1206likith/gesture-sentry/docs/guides/images/chassis-photo.png

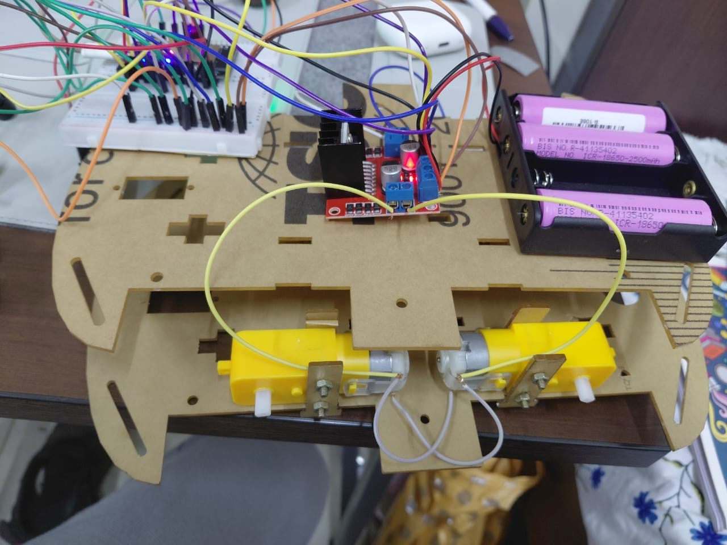
docs/guides/images/chassis-photo.png
