1206likith/gesture-sentry/docs/design/Advanced_Robotics_Project_Ideas.md

# 20 More Impressive Robotics + Embedded Systems Ideas — 4-Person Team

Upgrade tier from the sumo-bot/basic-demo list — these have more technical
depth, better demo "wow factor," and more genuinely interesting embedded
systems content (closed-loop control, sensor fusion, real-time
coordination), while still being scoped for 4 people in a few weeks (not
a research-lab timeline).

## Difficulty key
🟢 Same tier as sumo-bot (few weeks, moderate) · 🟡 Harder, needs one extra week / more careful tuning · 🔴 Genuinely ambitious, 5-6+ weeks, only if the team wants to push

---

**1. Self-Balancing Robot (Inverted Pendulum on Wheels)** 🟡
MPU6050 IMU + PID control loop keeps a 2-wheeled robot upright in real time — the classic "hard but learnable" control-systems project. Way more technically impressive than sumo because it's closed-loop control running continuously, not a discrete decision tree. Split: chassis/motor mounting (A), IMU+PID tuning (B — the hardest, most interesting part), motor driver firmware (C), app-based remote steering once balanced (D).

**2. Swarm of 3 Mini-Bots with Coordinated Behavior** 🔴
3-4 small bots communicate over ESP-NOW/BLE and perform coordinated formation-following or a simple "flocking" behavior (follow the leader, maintain spacing). Genuinely research-adjacent and a strong standout demo — each bot is simple individually, the coordination logic is the real content. Split naturally: each of 3 people builds/owns one bot, 4th person owns the coordination protocol + demo choreography.

**3. Autonomous Maze-Solving Robot (Flood-Fill / Wall-Following + Mapping)** 🟡
Beyond basic line-following: robot explores an unknown maze, builds an internal map, and on a second run takes the *optimal* solved path (flood-fill or A* on a grid). Genuinely impressive because it demonstrates it "learned" the maze. Split: chassis/motors+encoders (A), sensor array/wall-detection (B), pathfinding algorithm (C — the standout technical piece), UI showing the live map on a dashboard (D).

**4. Robotic Arm with Real Inverse Kinematics + Camera-Guided Pick-and-Place** 🔴
Upgrade of the earlier arm idea: instead of 3 hard-coded positions, use a phone/webcam + simple color-blob detection (OpenCV on a laptop, sending coordinates to the arm over WiFi) so the arm actually *locates* an object and computes the joint angles to reach it via inverse kinematics. This is the "genuinely impressive" version of the arm idea. Split: mechanical arm (A), servo/IK firmware (B — the hard math part), vision/color-detection pipeline (C), integration+calibration (D).

**5. Autonomous Line-Following Delivery Bot with Package Drop-Off Stations** 🟡
A line-following robot with RFID station-recognition — it detects which "station" it's at via an RFID tag embedded at each stop, and executes a scripted drop-off action (servo dumps a small payload) at the correct one, chosen via an app-selected destination before the run starts. More of a real "product demo" (mini delivery robot) than sumo's combat framing.

**6. Gesture-Controlled Robot (IMU-Wearable Glove → Robot Motion)** 🟢/🟡
A glove or wristband with an MPU6050 sends orientation data over BLE; tilting your hand forward/back/left/right drives the robot the same direction, in real time. Very demoable — a person visibly "steering with their hand" reads as much more impressive than a phone-app button, for similar build effort to the arm idea. Split: glove hardware+IMU (A), robot chassis/motors (B), gesture-classification firmware on the glove side (C), BLE link+robot-side motor mapping (D).

**7. Autonomous Fire-Fighting Robot (Flame Sensor + Water-Pump Extinguisher)** 🟡
Flame sensors (IR flame detector array) locate a small candle/flame source, robot navigates toward it and triggers a small water-pump/servo-spray mechanism to "extinguish" it — very popular competition-style project with strong safety-tech framing and a genuinely satisfying demo (robot finds and puts out a real flame). Split: chassis+pump/spray mechanism (A), flame-sensor array+localization (B), navigation firmware (C), integration/safety testing (D).

**8. Object-Sorting Conveyor with Color/Size Classification** 🟡
A small conveyor belt (DC motor + belt) moves objects past a color sensor (TCS3200) and/or an IR size-gate, and a servo-driven arm/flap diverts each object into the correct bin based on classification. Genuinely impressive "mini factory automation" demo, and technically rich (sensor calibration + timed actuation + classification logic). Split: conveyor mechanical build (A), color/size sensor calibration (B), sorting-logic firmware (C), bin mechanism + integration (D).

**9. Voice + Gesture Hybrid Smart Wheelchair/Mobility Model (small-scale demo)** 🔴
A scaled-down model (not full-size, for safety/cost) demonstrating assistive mobility tech: joystick + voice command + obstacle-avoidance override (ultrasonic emergency-stop regardless of command). Strong social-good framing, genuinely useful technical content (safety-override priority logic is a real embedded-systems lesson). Split similar to sumo's pattern but with a dedicated "safety override" firmware owner.

**10. Autonomous Drone-Style Ground Rover with GPS Waypoint Navigation** 🔴
Cheap GPS module + compass (HMC5883L) lets a rover navigate to GPS waypoints outdoors autonomously (drive to point A, then B, then C), rather than reacting only to nearby sensors. Genuinely more advanced than anything reactive-only (sumo, line-follower) because it requires real navigation math (bearing calculation, distance-to-waypoint). Needs outdoor testing space. Split: chassis/motors (A), GPS+compass integration (B — trickiest part, needs outdoor calibration), waypoint-navigation firmware (C), live-tracking dashboard (D).

**11. Robotic Arm + Sumo-Bot Hybrid: "Combat Arm" that Grabs and Ejects Objects from a Ring** 🟡
A genuinely fun combination: a stationary or slow-moving base with a robotic-arm-style gripper that must locate small objects (via ultrasonic/IR) within a ring and physically pick-and-eject them, rather than push. Combines the sensor-based ring-awareness logic of the sumo idea with real gripper mechanics — technically richer than either idea alone, still buildable in similar time.

**12. Self-Parking Robot Car (Ultrasonic Mapping + Reverse-Parking Maneuver)** 🟡
Robot uses ultrasonic sensors to detect a "parking gap" between two obstacles and autonomously executes a multi-step reverse-parking maneuver (a scripted but sensor-triggered sequence, like real self-parking cars) — genuinely satisfying to watch and technically non-trivial (must correctly judge gap size before committing to the maneuver).

**13. Robotic Sentry Turret (Pan-Tilt + Ultrasonic/PIR Target Tracking, Non-Lethal "Tag")** 🟢/🟡
A stationary pan-tilt mount (2 servos) with an ultrasonic or PIR sensor tracks and aims at a moving target (a person walking past), optionally firing a foam dart or laser-pointer "tag" when locked on. Very demoable, needs no chassis/motors at all — purely a tracking/aiming project, which is a nice change of pace and a faster build (fewer moving mechanical parts than a driving robot).

**14. Two-Robot "Capture the Flag" with Wireless Coordination** 🔴
Two autonomous robots on a small field, each trying to reach a "flag" zone first, using ultrasonic obstacle-avoidance and a simple WiFi/ESP-NOW channel to broadcast their own position so each robot can react to (or ignore) the other. Much more interesting than 1-robot sumo because of the added multi-agent-awareness dimension.

**15. Robotic Arm Assembly-Line Simulator (Multi-Station Handoff)** 🔴
Two small robotic arms pass an object between them in sequence (arm 1 picks from station A, hands to arm 2, arm 2 places at station B) — demonstrates real coordination/timing between two independent embedded systems, a genuinely more advanced "industrial automation" story than a single arm.

**16. Autonomous Wall-Climbing/Stair-Climbing Mini-Robot** 🔴
A tracked (not wheeled) chassis with a simple stair-climbing mechanism (offset tracks or a rocker-bogie-style suspension) — very high mechanical-build difficulty but an extremely strong demo if the team has some mechanical aptitude and wants the most "impressive-looking" hardware in this whole list.

**17. Smart Robotic Guide Dog / Obstacle-Guiding Cane (Assistive Tech)** 🟡
A handheld or robot-mounted device using ultrasonic sensors that vibrates/beeps with increasing intensity as an obstacle gets closer, simulating assistive navigation tech for visually impaired users. Strong social-good angle, technically simpler than a driving robot (no motors needed at all if built as a handheld cane), good if the team wants high impact for lower mechanical-build risk.

**18. Autonomous Robot Football/Soccer Player (Ball-Tracking + Goal-Scoring)** 🔴
Color-based ball detection (a bright orange/pink ball + simple color sensor or basic camera+laptop vision) drives the robot to chase and push the ball toward a goal. Genuinely popular competition category (RoboCup-style, scaled down), strong demo appeal, moderate-high difficulty from the vision/tracking side.

**19. Modular Snap-Together Robot Kit (Reconfigurable Chassis Demo)** 🟡
Instead of one fixed robot, build a chassis with quick-swap modules (swap a wheel-drive base for a tracked base, swap a gripper module for a sensor-only module) and demo 2-3 different "configurations" of the same core electronics. More of an engineering-design showcase than a single-behavior demo — good if the team wants to show design versatility rather than one flashy trick.

**20. Autonomous Warehouse "AGV" (Automated Guided Vehicle) with Barcode/QR Waypoints** 🟡
A line-following or grid-navigating robot that reads QR codes at each junction (via a cheap camera module or even a phone mounted on the robot running a QR-scanning app that sends the result over WiFi) to decide which path to take next, simulating a real warehouse AGV. Strong "real industry" framing (this is literally how Amazon warehouse robots work at a basic level).

---

## Comparison table (vs. the sumo-bot baseline)

| # | Idea | Difficulty | Extra weeks vs. sumo | Wow-factor | Best if team wants... |
|---|---|---|---|---|---|
| 1 | Self-balancing robot | 🟡 | +1 | Very high | Real control-systems learning (PID) |
| 2 | 3-bot swarm coordination | 🔴 | +2-3 | Highest | Most "research-y," most impressive to judges |
| 3 | Maze-solving + mapping | 🟡 | +1 | High | Algorithm-heavy, less mechanical risk |
| 4 | Vision-guided robotic arm | 🔴 | +2 | Very high | Computer vision + real IK math |
| 5 | Line-follow delivery bot | 🟡 | +0-1 | Medium-high | "Real product" framing, moderate risk |
| 6 | Gesture-controlled robot | 🟢/🟡 | +0-1 | High | Best effort-to-wow ratio on this list |
| 7 | Fire-fighting robot | 🟡 | +1 | High | Popular competition format, satisfying demo |
| 8 | Sorting conveyor | 🟡 | +1 | High | "Mini factory," different from driving robots |
| 9 | Assistive mobility model | 🔴 | +2 | High + social impact | Strongest social-good story |
| 10 | GPS waypoint rover | 🔴 | +2 | High | Real navigation math, needs outdoor space |
| 11 | Combat arm hybrid | 🟡 | +1 | High | Combines sumo + arm ideas cleverly |
| 12 | Self-parking robot | 🟡 | +1 | High | Very relatable "real car tech" demo |
| 13 | Sentry turret tracker | 🟢/🟡 | +0 | High | Fastest build, no chassis/motors needed |
| 14 | 2-robot capture-the-flag | 🔴 | +2 | Very high | Multi-agent systems, most "alive" demo |
| 15 | Dual-arm handoff | 🔴 | +2-3 | Very high | Industrial-automation storytelling |
| 16 | Stair-climbing robot | 🔴 | +2-3 | Highest visual | Team has mechanical/CAD strength |
| 17 | Assistive guide-cane | 🟡 | +0 | Medium-high | Lowest mechanical risk, high social impact |
| 18 | Robot soccer player | 🔴 | +2 | Very high | Vision+sports framing, popular format |
| 19 | Modular snap-together kit | 🟡 | +1 | Medium-high | Engineering-design showcase over one trick |
| 20 | QR-code AGV | 🟡 | +1 | High | "Real Amazon warehouse" framing |

## My honest recommendation

If the goal is genuinely "better and more impressive than sumo, but still finishable" — **#1 (self-balancing robot)**, **#6 (gesture-controlled robot)**, or **#13 (sentry turret)** are the sweet spot: each is a clear step up in technical sophistication and demo appeal, without jumping into the 5-6-week 🔴 tier.

If the team wants to genuinely swing for "best in the room" and has some slack in the timeline: **#2 (swarm coordination)** or **#14 (two-robot capture-the-flag)** are the most impressive on this entire list — multi-agent systems reliably stand out because almost no student teams attempt them, but budget real extra time and expect more integration pain across 3-4 separate robots instead of one.
