1206likith/gesture-sentry/docs/design/comparison_dashboard.html

ESA_Friend_Project · decision reference

# Every project option, side by side

Four idea sets were generated across this thread for slightly different goals. This page puts all 62 ideas in one sortable table, plus the two options that have a full build spec written. Use the filters to narrow by source or by budget/timeline.

SET 1 · 21 ideas

### Course-paper style

BACSE324-scoped, needs a paper/patent angle. Mostly 1–3 person scope. Project_Ideas_Brainstorm.md

SET 2 · 20 ideas

### Simple hardware demo

No paper needed. 50/50 hw/sw, built for a clean 4-way split, few weeks. Hardware_Demo_Project_Ideas.md

SET 3 · 20 ideas

### Advanced robotics

More technical depth & demo wow-factor than Set 2's baseline. Advanced_Robotics_Project_Ideas.md

2 full specs

### Built out in full

BOM, 4-way split, control logic, week-by-week timeline already written.

## Fully-specced options

Only these two have a complete build document — BOM with costs, exact 4-person role split, control logic, and a week-by-week timeline.

Superseded

### Voice-Controlled Robotic Arm

Set 2, idea #15 — basic pick-and-place

Cost

~₹4,000–4,500

Timeline

3 weeks + 1 buffer

Split

Mechanical build / servo firmware / app+voice / integration

Note

Replaced by the sumo robot as the working choice; kept here as reference. A vision-guided upgrade of this idea exists in Set 3 (#4).

Current pick

### Autonomous Sumo-Fighting Robot

Replaces the arm — chosen working project

Cost

~₹3,500–4,000

Timeline

3–4 weeks realistic, up to 5–6 if tuning drags

Split

Chassis/drivetrain / sensor mounting / control firmware / integration+tuning

Difficulty

Moderate overall — mechanical grip/weight and IR-edge calibration are the real time sinks, not the code

## All 62 ideas

Filter by source set, then scan cost and difficulty. "Best for" is copied from each idea's own writeup — it's the one-line reason to pick it.

Source All (62) Course-paper (21) Simple hw-demo (20) Advanced robotics (20)

Set | Idea | Domain / what it demos | Cost or Δ vs. baseline | Difficulty | Best for
Set 1 | SPI eavesdrop / injection | Robotics / drone sensors | ~₹0 | Moderate | Sensor-fusion story
Set 1 | UART command injection | Industrial actuators | ~₹0 | Low–mod | Fast, simple build
Set 1 | Modbus RTU injection | Industrial / PLC | ~₹200 | Moderate | Strong "PLC" framing
Set 1 | I2C address-spoofing | Consumer multi-sensor | ~₹0 | Moderate | Differentiates from existing I2C project
Set 1 | SPI flash glitching | Hardware / secure boot | ~₹150 | High | Wow-factor, riskier
Set 1 | Priority inversion | Pure RTOS | ₹0 | Low | Cheapest + fastest, textbook-safe
Set 1 | GPIO interrupt storm | Generic embedded | ~₹0 | Low | Easiest live demo
Set 1 | Timer / tick manipulation | Safety-critical timing | ~₹0 | Moderate | Nuanced RTOS-internals angle
Set 1 | Watchdog bypass / abuse | Safety systems | ₹0 | Moderate | Under-explored, examiner-friendly
Set 1 | Stack-overflow corruption | Firmware reliability | ₹0 | Moderate | Strong "found a real bug" narrative
Set 1 | ADC glitching via rail noise | Automotive / industrial sensors | ~₹150 | Moderate | Hands-on hardware feel
Set 1 | Sleep/wake timing attack | Battery IoT / wearables | ~₹100 | Moderate | Attacks energy budget, not CPU time
Set 1 | Brown-out induced reset | Safety-critical ECUs | ~₹100 | Moderate | Real automotive failure class
Set 1 | NTP poisoning | Distributed sensor nets | ₹0 | Moderate | Multi-node distributed-systems story
Set 1 | MQTT broker flooding | Cloud IoT | ₹0 | Low–mod | Real-product framing, portfolio value
Set 1 | DNS spoofing | IoT / OTA security | ₹0 | Moderate | Timely, maps to real CVEs
Set 1 | Multi-core task migration jitter | General computing | ₹0 | Low | Fastest / cheapest overall
Set 1 | Cache / flash WCET variance | RT systems theory | ₹0 | Low–mod | Safest, most "textbook"
Set 1 | GPS/GNSS spoofing | Automotive / drone nav | ~₹500 | High | Highest wow-factor, check parts first
Set 1 | Bluetooth Classic SPP flood | Legacy industrial serial | ₹0 | Low | Weakest pick, well-trodden
Set 1 | CAN-FD bit-rate-switch | Next-gen automotive | ~₹300+ | High | Most novel, riskiest on hardware sourcing
Set 2 | Smart parking indicator | Ultrasonic/IR ×4–6, LED matrix | 2–3 wks | Low | Fast, cheap, very demoable
Set 2 | Gas leak + auto-vent | MQ gas sensor, relay, fan, buzzer | 2–3 wks | Low | Strong safety story
Set 2 | Smart irrigation | Soil sensors, relay, pump | 2–3 wks | Low | Classic, cheap, reliable parts
Set 2 | RFID attendance / lock | RFID reader, servo lock | 2–3 wks | Moderate | Clean 4-way split
Set 2 | Home automation (app + voice) | Relay bank | 2 wks | Low | Fastest software-heavy option
Set 2 | Line-follow / obstacle robot | Chassis, motors, IR/ultrasonic | 3–4 wks | Moderate | Best "robot" wow-factor at this tier
Set 2 | Smart dustbin | Servo lid, ultrasonic ×1–2 | 2 wks | Low | Very simple, cheap
Set 2 | Weather station | Temp/humidity/pressure/rain/light | 2–3 wks | Low | Software / dashboard-heavy
Set 2 | Energy meter | Current / voltage sensor | 3 wks | Moderate | Practical, needs electrical care
Set 2 | Dual-factor door lock | Fingerprint + RFID + servo | 3–4 wks | Moderate | Most "security system" feel
Set 2 | Watering + grow-light | Moisture + LDR + 2 relays | 3 wks | Moderate | More subsystems to split
Set 2 | Mini smart traffic light | LEDs ×4, ultrasonic ×4 | 3 wks | Moderate | Best visual demo at this tier
Set 2 | Fall-detection wearable | MPU6050 wearable | 2–3 wks | Low–mod | Medical-IoT framing
Set 2 | Adaptive street-light model | LDR + PIR, LEDs | 2 wks | Low | Simplest firmware, more mounting work
Set 2 | Voice / app robotic arm (superseded) | 3–4 servo arm | 3–4 wks | Moderate | Good hardware build challenge — full spec exists, now replaced by sumo
Set 2 | Smart scarecrow | PIR/ultrasonic, buzzer, servo | 2 wks | Low | Fun, easy indoor demo
Set 2 | Health vitals monitor | Pulse + temp sensor wearable | 2–3 wks | Low–mod | Clean 3-way split
Set 2 | Smart bike safety system | Buttons, LEDs, accelerometer, ultrasonic | 3 wks | Moderate | Good mechanical-mounting work
Set 2 | Automated pet feeder | Servo/auger dispenser, load cell/IR | 3 wks | Moderate | Popular, well-documented
Set 2 | Smart mailbox notifier | Reed switch/IR, optional weight sensor | 1–2 wks | Low | Fastest / simplest overall
Set 3 | Self-balancing robot | MPU6050 + PID, inverted pendulum | +1 wk | Moderate | Real control-systems learning (PID)
Set 3 | 3-bot swarm coordination | ESP-NOW/BLE formation-following | +2–3 wks | High | Most "research-y," most impressive to judges
Set 3 | Maze-solving + mapping | Flood-fill / wall-following + live map | +1 wk | Moderate | Algorithm-heavy, less mechanical risk
Set 3 | Vision-guided robotic arm | Color-blob detection + inverse kinematics | +2 wks | High | Computer vision + real IK math
Set 3 | Line-follow delivery bot | RFID station stops + payload drop | +0–1 wk | Moderate | "Real product" framing, moderate risk
Set 3 | Gesture-controlled robot | IMU glove over BLE → motion | +0–1 wk | Low–mod | Best effort-to-wow ratio on this list
Set 3 | Fire-fighting robot | Flame sensor array + pump/spray | +1 wk | Moderate | Popular competition format, satisfying demo
Set 3 | Sorting conveyor | Color/size sensor + diverter servo | +1 wk | Moderate | "Mini factory," different from driving robots
Set 3 | Assistive mobility model | Joystick + voice + safety-override | +2 wks | High | Strongest social-good story
Set 3 | GPS waypoint rover | GPS + compass, real navigation math | +2 wks | High | Real nav math, needs outdoor space
Set 3 | Combat arm hybrid | Sumo ring-awareness + gripper eject | +1 wk | Moderate | Combines sumo + arm ideas cleverly
Set 3 | Self-parking robot | Ultrasonic gap-mapping + reverse maneuver | +1 wk | Moderate | Very relatable "real car tech" demo
Set 3 | Sentry turret tracker | Pan-tilt + ultrasonic/PIR tracking | +0 wk | Low–mod | Fastest build, no chassis/motors needed
Set 3 | 2-robot capture-the-flag | Wireless position broadcast + strategy | +2 wks | High | Multi-agent systems, most "alive" demo
Set 3 | Dual-arm handoff | Two arms pass an object in sequence | +2–3 wks | High | Industrial-automation storytelling
Set 3 | Stair-climbing robot | Tracked chassis, offset/rocker suspension | +2–3 wks | High | Team has mechanical/CAD strength
Set 3 | Assistive guide-cane | Ultrasonic + vibration feedback | +0 wk | Moderate | Lowest mechanical risk, high social impact
Set 3 | Robot soccer player | Color-based ball tracking + goal-scoring | +2 wks | High | Vision + sports framing, popular format
Set 3 | Modular snap-together kit | Quick-swap chassis modules | +1 wk | Moderate | Engineering-design showcase over one trick
Set 3 | QR-code AGV | Grid nav + QR junction reads | +1 wk | Moderate | "Real Amazon warehouse" framing

## Where this leaves you

If your friend wants "better than sumo" but still low-risk: Self-balancing robot, gesture-controlled robot, or sentry turret tracker (Set 3, #1/#6/#13) — each is a genuine step up in technical depth and demo appeal without leaving the "few weeks, moderate difficulty" zone the sumo bot occupies.

If the team wants to swing for the most impressive thing on this entire page: 3-bot swarm coordination or 2-robot capture-the-flag (Set 3, #2/#14) — genuinely stand out because almost no student team attempts multi-agent coordination, but budget real extra weeks and expect more integration pain across multiple robots.

If the goal shifts back to course marks (paper/patent) instead of a standalone demo: Set 1's priority-inversion or GPIO-interrupt-storm ideas need zero extra hardware and map directly onto Module 4 (RTOS) of the syllabus.

62 ideas across 4 documents · docs/Project_Ideas_Brainstorm.md · Hardware_Demo_Project_Ideas.md · Advanced_Robotics_Project_Ideas.md · Robotic_Arm_Full_Spec.md · Sumo_Robot_Full_Spec.md
