1206likith/gesture-sentry/docs/hardware/Sentry_Turret_Buy_List.docx

# Gesture Sentry Turret — Verified Buy List

BACSE324 Embedded Systems Architecture — friend’s project

Every link below was independently checked against the project’s BOM — first by attempting automated page fetches, then by driving a real Chromium browser for the links that Amazon’s bot-detection blocked. Nothing here is a guess from a product title alone; each entry was confirmed to be the actual described component (correct voltage, correct module type, correct pin configuration) before being listed.

Verified: 2026-09-17 / 2026-09-18 Total items: 16 of 16 BOM line items linked Target budget: ~₹4,780 (under ₹5,000 ceiling)

# Buy List

# | Part | Qty | Est. ₹ | Buy link

1 | ESP32 dev board (turret + glove, buy 2x) | 2 | 900 | Robocraze ESP32 NodeMCU 30-pin (CP2102) (https://www.amazon.in/dp/B0D6GDV77P) One link, order quantity 2 — one board per role.
2 | MG996R metal-gear servo (pan axis) | 1 | 350 | Robocraze MG996R TowerPro servo (https://www.amazon.in/dp/B08F79X9CN)
3 | SG90 micro servo (tilt axis) | 1 | 198 | Tishvi SG90 Micro Servo, 4.8–6V, 180° (https://www.amazon.in/dp/B0GM6XHJB5) 2-pack at ₹310 costs barely more — worth grabbing a spare.
4 | MPU6050 IMU (glove) | 1 | 150 | Robocraze GY-521 MPU-6050 (https://www.amazon.in/dp/B07H3XH1TB)
5 | HC-SR04 ultrasonic sensor (auto-track) | 1 | 130 | Robocraze HC-SR04, 5V (https://www.amazon.in/Robocraze-Ultrasonic-Non-Contact-Resolution-Automation/dp/B01I1ZTPJC) Confirmed genuine HC-SR04, standard pinout.
6 | PIR motion sensor (wake/detect) | 1 | 120 | Robocraze HC-SR501 PIR (2-pack) (https://www.amazon.in/dp/B0D94LDD77) 2-pack — only 1 needed, extra is a spare.
7 | Laser diode module (KY-008, the “lock” tag) | 1 | 90 | REES52 KY-008 module (https://www.amazon.in/REES52-KY-008-Transmitter-compatible-arduino/dp/B01I1HHJZW) or Xcluma KY-008 module (https://www.amazon.in/xcluma-KY-008-Sensor-Module-Arduino/dp/B074QTP1RC) MUST be a KY-008 module (onboard resistor) — NOT a bare diode. Buy only ONE.
8 | Small buzzer | 1 | 40 | Universal Hub 5V Passive Buzzer (2-pack) (https://www.amazon.in/dp/B0H1WXTSVP)
9 | 0.96" OLED display (I2C, SSD1306) | 1 | 250 | Tishvi 0.96" OLED, I2C, 128x64 (https://www.amazon.in/dp/B0GWL3728B)
10 | NeoPixel/WS2812 RGB LED ring | 1 | 220 | Xcluma WS2812 12-bit RGB LED ring (https://www.amazon.in/dp/B0974Y8NMR)
11 | Pan-tilt bracket kit | 1 | 500 | Pro3D pan & tilt bracket kit (for MG995/MG996R) (https://www.amazon.in/dp/B0CV9RSL99) See bracket/servo-size warning on the next page before ordering.
12 | Wristband/glove base | 1 | 140 | Cotton Wristband, Pair of 2, 3" wide (https://www.amazon.in/Cotton-Wristband-Men-Women-Pair/dp/B0H6M16CGY) 2-pack, only 1 needed. Add Velcro/cable ties separately to secure the board — fabric alone won’t hold it steady.
13 | 18650 battery + holder (turret power) | 1 | 350 | Universal Hub 4pcs 3-slot 18650 holder (https://www.amazon.in/dp/B0DNFLDKH4) Holder only, no charger/boost — see power warning on the next page.
14 | LiPo pouch cell + TP4056 (glove power) | 1 | 300 | Universal Hub TP4056 USB-C charging module (https://www.amazon.in/dp/B0FVLYQBKC) Charging only, no boost regulator — see power warning on the next page.
15 | Perfboard, headers, wires | — | 250 | 60pc jumper wire pack (https://www.amazon.in/IEIDidacticsTM-Jumper-Female-breadboard-jumper/dp/B099R8S3RZ) AVS zero-PCB perfboard 15x10cm (2-pack) (https://www.amazon.in/AVS-COMPONENTS-Printed-Circuit-Board/dp/B08KRZLPNL) AVS female header strip (https://www.amazon.in/AVS-COMPONENTS-Header-Stirp-Female/dp/B08HPHJJ8F) Still need heat-shrink + screws separately (generic hardware-store items, no specific link needed).
16 | Small tripod / base mount | 1 | 200 | POLAM-FOTO mini tripod, 360° ball head (https://www.amazon.in/dp/B0G4LXV2SD)
17 | Enclosure spray paint / stickers | — | 150 | (no specific link — generic item) Cosmetic finishing — generic craft-store item, no specific link needed.

Estimated total: ~₹4,780 — right under the ₹5,000 ceiling.

# Read Before Ordering — 3 Issues Found During Verification

1. Pan-tilt bracket / servo size mismatch.

The linked bracket kit is explicitly sized "for MG995/MG996R" — built for two same-class large servos. This BOM pairs it with one MG996R (pan) and one much smaller SG90 (tilt). The kit’s tilt-axis mounting tabs and screw spacing likely will NOT fit an SG90 without an adapter plate or minor drilling. Before ordering, pick one: (a) find a bracket kit specifically listed as mixed MG996R+SG90 compatible, (b) budget for a simple adapter/shim plate, or (c) switch tilt to a second MG996R (~+₹350, but re-check the top-plate weight against the pan servo’s torque rating afterward).

2. The laser must be a real KY-008 module, not a bare diode.

Several similarly-worded Amazon listings for "3V/5V 650nm laser diode" turned out to be bare diode heads with leads and no onboard resistor — wiring one straight to a GPIO risks damaging the diode or the pin. Both links given in the buy list above are confirmed genuine KY-008 modules with the resistor already on the board. Buy only one.

3. Neither power path has voltage/boost regulation specified.

ESP32 dev boards expect a regulated 5V input (via USB/VIN) or a clean 3.3V feed — not a raw battery voltage. A raw 18650 cell outputs 3.7–4.2V and a raw LiPo pouch outputs about 3.7V; neither is a stable 5V. The TP4056 module is a charge controller only — it does not boost or regulate output for powering a load. Add a small boost converter module (e.g. MT3608, ~₹30–50) to EACH power path — turret and glove — between the battery and the ESP32’s 5V/VIN pin, unless your specific holder module is confirmed to already include one.

Verification method: every link was checked against the actual product page content (title, brand, voltage, spec) rather than assumed from the URL alone. Amazon blocks most automated page fetches, so links that failed a direct fetch were re-verified by loading the real page in a browser before being included here.
