1206likith/gesture-sentry/docs/hardware/glove_mounting_diagram.png

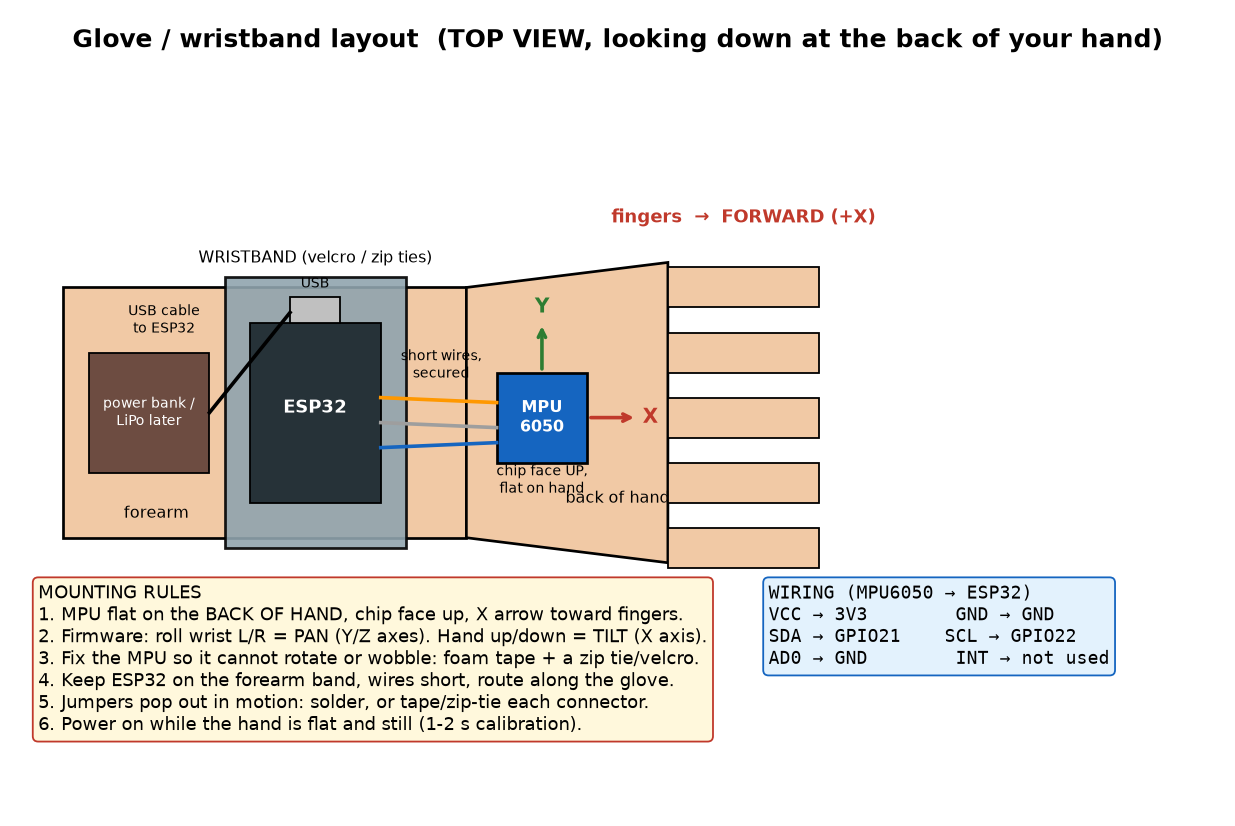
docs/hardware/glove_mounting_diagram.png
