1206likith/gesture-sentry/docs/hardware/pan_tilt_DIY_diagram.png

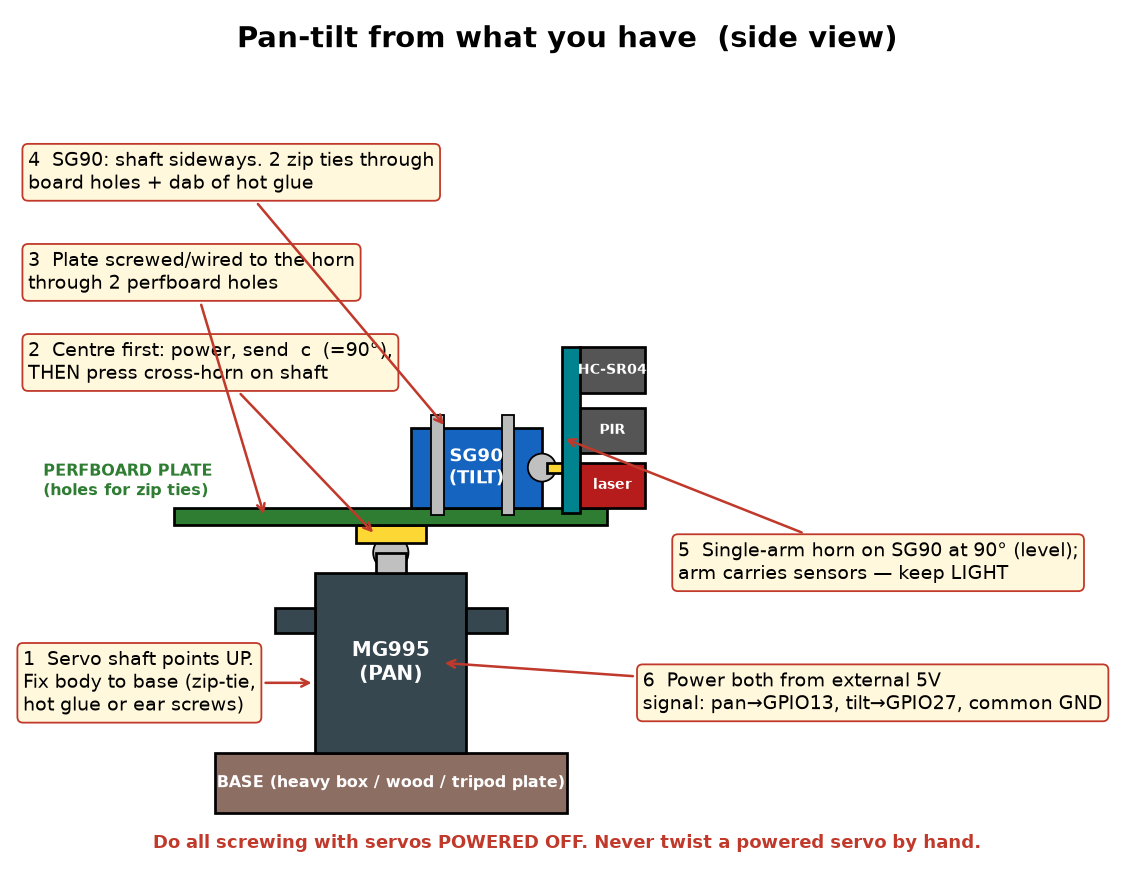
docs/hardware/pan_tilt_DIY_diagram.png
