1206likith/gesture-sentry/docs/guides/PROGRESS_2026-10-27.md

# Gesture Sentry — progress and results, 2026-10-26/27

Everything below was observed this session unless marked "not verified". Serial output proves the boards commanded something; only the user's eyes prove a wheel turned or an LED lit.

## Hardware verified
| Item | Result |
|---|---|
| Glove MPU (MPU6500, WHO_AM_I 0x70, addr 0x68) | live data; SDA/SCL wiring correct; chip mounted upside-down against the hand (handled by the learned orientation) |
| Glove -> turret Bluetooth link | link=1, glove angles reach the turret live, gestures arrive and are acted on |
| OLED (0x3C) | answers after reseating; text drawn (user saw text); not re-checked after the last firmware |
| Servo outputs | pan GPIO13 / tilt GPIO27 attached at 50 Hz; physical sweep not confirmed by the user |
| L298N wheels | all four wheel/direction pulses at duty 180 worked ("all worked"); stayed still with no command |
| Ultrasonic | returns echoes; readings erratic (needs a fixed-target test) |
| PIR, laser | NOT tested (laser needs a confirmed safe beam path) |

## Faults found and what they were
- "Car runs full speed on battery": not firmware (wheels start disabled, drive needs a command). Cause class: L298N ENA/ENB jumper caps and/or ESP32 powered badly on battery. Resolved when ENA/ENB were wired to GPIO2/GPIO15 with the caps removed: wheels stay still until commanded.
- Wheels did not turn from the glove: glove-requested duty was ~61-64/255, below what the motors need to start. Fixed in firmware: duty now starts at MIN_PWM=90 past the dead zone and ramps to MAX_PWM=200 (was 0..120). Flashed to the turret; the forward test with the new duty was NOT completed (paused).
- "Diagonal wheels in opposite directions" (earlier): each motor pair needs one motor's wires swapped. User later reported all wheels working on pulses; per-motor forward direction under glove drive NOT re-confirmed.
- Flashing the turret fails with "wrong boot mode 0xb" when ENA is on GPIO2 and the L298N pulls it up. It did flash with ENA wired in the later runs, but unplug ENA if it fails.
- USB serial ports change (COM5/COM8/COM14) when cables or boards are swapped; identify a board by its output (`link=` = turret, `GLOVE` = glove), not by COM number. At pause, both ports showed W1 boards, so neither board was on the PC.
- Disk: C: is 100% full. Host-compiler caches were put on L:.

## Glove orientation (learned, stored in the glove's flash)
Serial commands on the glove (115200): `f` capture flat, `d` capture fingers-down (do `f` then tip and send `d`), `o` one-shot version, `c` recalibrate neutral (hold flat), `r` reset. Saved frame (second calibration): fwd=(-0.98,0.09,-0.18) left=(0.08,1.00,0.04) up=(0.18,0.02,-0.98). After `d` always do `c` with the hand flat: the automatic recalibration runs while still tipped. A glove that reboots calibrates neutral in whatever pose it is in (this caused a bogus -96 degree roll once).
Verified: roll right -> pan above 90; fingers down -> tilt below 90.

## Gestures (see GESTURES.md)
Real glove results: double flick, shake (switches drive/turret) and punch were detected on the real glove and the turret acted on them. Sweeps were not (see below). STILL no longer stops the car (it conflicted with the half-second level hold used to arm the wheels); it is only reported.
Measured on this user: a jab gives a 5-8 m/s2 forward spike (slow filter), rotation under ~4.7 rad/s; the user's "sweep" is an edge-on swat with 10-14 rad/s rotation about the real vertical and a forward push.
Synthetic tests (tests/test_gestures.cpp, host compiler via Zig): all gestures >90%, 0 false actions in a simulated hour. They check logic only, not real-wrist accuracy.

## State of the source vs what is flashed
- Turret: flashed = latest source (STILL no-op, MIN_PWM 90 / MAX_PWM 200, parses `seq,pan,tilt[,evSeq,evCode]`).
- Glove: flashed = an EARLIER build (faster punch filter, yaw about the vertical, debug "GLOVE peak" lines; but before the sweep/punch-window fix). The source in glove/Gestures.h is newer and NOT flashed.
- OPEN BUG in the newer source: 1 deterministic synthetic case fails ("sweep (yaw +) -> SWEEP_LEFT") and sweep trials are 94.7%, down from 100% after the sweep/punch-window change. Investigate before flashing.

## Next steps
1. Fix the failing sweep case, rerun tests, flash the glove, re-test punches/sweeps/shake on the real hand.
2. Finish the drive test with the new duty (wheels lifted first): forward, reverse, steer, then confirm all four wheels turn the same way; then floor test.
3. Power the ESP32 properly from battery (buck to 5V, or L298N 5V pin only if the pack is ~7-8V); measure the pack first. Never drive from a 4S (16.8V) pack unregulated.
4. Mount the pan/tilt servos (docs/hardware/pan_tilt_DIY_diagram.png) and the glove (docs/hardware/glove_mounting_diagram.png); test PIR, ultrasonic at a fixed target, and (only with a safe beam path) the laser.
5. Decide whether the course needs a TinyML component; the current detector is rule-based.
