1206likith/gesture-sentry/docs/hardware/Sentry_Turret_Build_Manual.docx

GESTURE-CONTROLLED SENTRY TURRET

End-to-End Build Manual & Project Plan

On-device TinyML gesture recognition · pan-tilt auto-tracking · 4-person build, 4 weeks, ₹4,780 budget

Team size | 4 people
Timeline | 4 weeks
Budget | ₹4,780 (ceiling ₹5,000)
Core tech | ESP32 × 2, MPU6050, TFLite Micro (Edge Impulse)
Gesture set | 5 core + 3 stretch (8 total)

# Contents

# 1. Project Overview

A pan-tilt sentry turret that auto-tracks a moving target using an ultrasonic sensor and a PIR motion sensor, and can be switched into manual mode and driven by real hand gestures. Gesture recognition runs entirely on-device: a small trained model (TensorFlow Lite Micro, built via Edge Impulse) classifies IMU motion patterns on the glove's own ESP32 and sends a recognized command over Bluetooth Low Energy — no laptop or phone is needed at demo time.

This build replaces two earlier candidates considered for this slot: a voice-controlled robotic arm (mechanically heavier, servo-IK dependent) and an autonomous sumo-fighting robot (a solid baseline, but this turret gives more technical depth for similar cost and less mechanical risk, since it needs no chassis, drivetrain, or wheels).

## 1.1 Why this project

- No drivetrain to fight — the single biggest source of unreliability in student robotics builds (traction, motor stall, uneven floors) simply doesn't exist here.
- Genuine embedded-AI content — an on-device trained model is a real technical differentiator, not just sensor-threshold logic.
- Clean 4-way split with almost no idle time — three people can work fully in parallel for two weeks before any integration is needed.
- Strong, fast demo — auto-track alone is a complete fallback demo; the gesture layer is additive polish, not a single point of failure.

Read this first — the honest risk call

Training 8 gestures to run reliably on-device in 4 weeks, with a team likely new to ML, is ambitious.

This plan includes a fallback checkpoint at the end of Week 2: if the core 5 gestures aren't hitting roughly 85%+ accuracy on someone new by then, the team deliberately drops the 3 stretch gestures rather than risking a broken demo.

This is not a failure mode — it is the plan.

# 2. Bill of Materials

Total: approximately ₹4,780, against a ₹5,000 ceiling. No extra hardware is required for the AI upgrade — the trained model runs entirely on the ESP32 already listed below; the real cost of "AI" here is time (data collection and training), not parts.

Part | Qty | ₹ | Notes
ESP32 dev board (turret) | 1 | 450 | Servo control + BLE receive + action mapping
ESP32 dev board (glove) | 1 | 450 | Runs the on-device TFLite Micro model
MG996R metal-gear servo (pan) | 1 | 350 | Carries the full sensor rig — needs the torque
SG90 micro servo (tilt) | 1 | 130 | Lighter axis, SG90 is sufficient
MPU6050 IMU (glove) | 1 | 150 | Accelerometer + gyro — the model's input signal
HC-SR04 ultrasonic (auto-track) | 1 | 130 | Front-facing distance/presence sensing
PIR motion sensor (wake/detect) | 1 | 120 | Wakes auto-tracking on motion
Laser diode module (3V, KY-008) | 1 | 90 | Class 1/2 visible dot only — see Section 7 safety note
Small buzzer | 1 | 40 | Audible confirmation on gesture + lock
0.96" OLED display (I2C, SSD1306) | 1 | 250 | Live mode / gesture label / confidence / status
WS2812 RGB LED ring (8–12 LED) | 1 | 220 | Status ring: green / amber / red
Pan-tilt bracket kit (generic) | 1 | 500 | Buy a kit — do not fabricate from scratch
Wristband/glove base | 1 | 100 | Mounts the glove ESP32 + MPU6050
18650 battery + holder + charger (turret) | 1 | 350 | Untethered turret
LiPo 3.7V pouch cell + TP4056 (glove) | 1 | 300 | Untethered glove — essential for the illusion to work
Perfboard, headers, wires, heat-shrink, screws | – | 250
Small tripod / base mount | 1 | 200 | Height matters for demo visibility
Cosmetic finishing (paint, labels) | – | 150 | Disproportionate wow-per-rupee

# 3. The AI Toolchain

Use free, well-documented tools only — do not attempt to build the ML pipeline from scratch in the Arduino IDE.

## 3.1 Edge Impulse (free tier, web-based)

The standard path for “collect IMU data → train a model → export TFLite Micro → run on ESP32.” It has an official ESP32 tutorial and handles data collection, labeling, training, and C++ export in one flow.

## 3.2 Model type

Use Edge Impulse's default “Motion Classification” project template — a small 1D-CNN or fully-connected network over a fixed-length window of accelerometer+gyro samples (roughly 1–2 second windows at 50–100Hz). Do not design a custom architecture.

## 3.3 Data collection — the real bottleneck

Each gesture needs approximately 40–60 recorded samples per team member (150–250 samples per gesture in total) to generalize beyond one person's exact motion style. This is the single biggest time cost in the whole project — budget real hours across Week 1–2, not an afternoon.

Most common TinyML mistake

A model trained on one person's motion style may not generalize to anyone else.

Always validate accuracy with someone who did NOT contribute training data before trusting the number.

# 4. The Gesture Set

8 gestures total: a core 5 that alone form a complete, demoable system, and 3 stretch gestures attempted only once the core 5 are solid.

# | Gesture | Command | Tier

1 | Tilt left / hold | Pan left (continuous while held) | Core
2 | Tilt right / hold | Pan right (continuous while held) | Core
3 | Sharp forward flick | LOCK — laser + buzzer + red ring | Core
4 | Wave (side-to-side shake) | Reset to idle / auto-track | Core
5 | Quick double-tap motion | Switch AUTO ↔ MANUAL | Core
6 | Tilt up / hold | Tilt servo up (continuous) | Stretch
7 | Tilt down / hold | Tilt servo down (continuous) | Stretch
8 | Circular wrist rotation | “Scan” — full sweep | Stretch

Collect extra training samples specifically for gesture 3 (LOCK) — it is the demo's punchline moment and needs to be the most reliable of the eight.

# 5. Team Split — 4 People

## Person A — Turret mechanical build

Assemble the pan-tilt bracket, mount both servos plus ultrasonic, PIR, laser, and LED ring, mount on the tripod/base, and own the enclosure/paint cosmetic pass.

Deliverable: turret physically complete, all sensors/actuators wired to header pins, moves smoothly through full pan/tilt range by hand.

## Person B — Turret firmware (the brain)

ESP32 code that reads ultrasonic + PIR for auto-track mode, receives recognized gesture commands over BLE, maps each to a servo/laser/buzzer action, and drives the OLED + RGB ring + buzzer based on current state.

Deliverable: turret auto-tracks a moving hand/object, and correctly executes each incoming gesture-command label with OLED + LED ring reflecting state.

## Person C — Gesture-AI: data collection, training, glove firmware

The project's critical path. Assembles the wristband, runs the Edge Impulse data-collection flow across multiple team members, trains and validates the model, exports the TFLite Micro model into the glove's sketch, and sends the classified gesture label over BLE.

Deliverable: glove classifies gestures locally and sends a clean label string over BLE — no laptop at demo time.

## Person D — Integration, dataset support, and demo

Helps C with data collection (recording is faster with two people), wires the recognized-gesture pipeline into the turret's action-mapping, tests full-system range/latency/accuracy, handles battery-life testing, writes and rehearses the demo script, and owns cosmetic finishing.

Deliverable: full gesture-to-action pipeline works reliably; system runs untethered for a full 10+ minute demo without dying.

Note the critical path

Person C's role is now the project's bottleneck — B and D cannot fully test their integration until a trained model exists.

Front-load data collection in Week 1, not Week 2.

# 6. Control Architecture

## 6.1 Two modes, one clean switch

AUTO: turret scans/tracks on its own — PIR wakes it, ultrasonic estimates direction/distance. MANUAL: the glove's on-device model classifies gestures and the turret executes the recognized command. Switching is itself the MODE_SWITCH gesture (double-tap motion); keep a physical button on the turret as a manual fallback in case that gesture misclassifies live.

## 6.2 Recognition, not simple tilt-mapping

The glove continuously samples the IMU into a fixed-length window, runs the trained model on that window, and outputs a gesture label only once classification confidence crosses a threshold (about 80%) — this avoids false triggers from incidental hand movement between intentional gestures. This on-device classification is the project's real technical content.

## 6.3 State feedback

- OLED: current mode, last recognized gesture label + confidence %, live distance reading (auto mode), status word (SCANNING / TRACKING / LOCKED).
- RGB ring: green = idle/scanning, amber = tracking or gesture recognized, red = locked-on.
- Buzzer: short beep on any recognized gesture, distinct triple-beep on lock.

# 7. Week-by-Week Timeline

## Week 1 — Hardware bring-up + data collection starts immediately

- A: assemble bracket, mount both servos, confirm full mechanical range of motion by hand.
- B: get ESP32 talking to both servos (sweep test); get ultrasonic + PIR reading raw values to serial monitor.
- C: assemble the glove; set up the Edge Impulse project; begin recording gesture samples for the core 5 immediately — the longest-lead-time task in the project.
- D: order any missing parts immediately; help C record gesture samples (two people recording is much faster than one).

Milestone: turret moves through full range under code; glove streams IMU data to Edge Impulse; at least 30 samples per core-5 gesture collected, from more than one team member.

## Week 2 — Model training + core logic — FALLBACK CHECKPOINT at end of week

- A: mount ultrasonic/PIR/laser/LED ring onto the finished bracket in final positions; begin cosmetic work.
- B: write auto-track logic; wire up OLED + RGB ring + buzzer with placeholder states; write the BLE receiver that maps gesture labels to actions.
- C: finish core-5 data collection (target 150–250 samples/gesture), train the first model, check the confusion matrix, export to TFLite Micro, flash to the glove, confirm labels print to serial.
- D: QA the data collection/labeling; stress-test the trained model with people who did NOT provide training data.

Checkpoint — end of Week 2

Is the core-5 model hitting roughly 85%+ accuracy on someone new?

YES → proceed to stretch gestures 6–8 in Week 3 alongside integration.

NO → do not attempt gestures 6–8. Spend the start of Week 3 collecting more core-5 data instead, and simplify the gesture set further if needed (e.g. drop to the 3–4 most-distinct gestures).

Milestone: turret auto-tracks a hand in front of it (bench test); glove correctly classifies core-5 gestures locally and prints labels to serial (BLE transmission not required yet).

## Week 3 — Integration (scope depends on Week 2's checkpoint)

- D leads: wire the glove's classified gesture labels over BLE into the turret's action-mapping; get the full manual-mode pipeline working end-to-end.
- A: finish cosmetic pass — paint, labels, cable management, battery placement inside an enclosure.
- B: polish the OLED/LED-ring state machine so every state looks clean, no flicker/lag.
- C: if checkpoint passed — collect data for stretch gestures 6–8, retrain, re-validate with new people. If checkpoint did not pass — stay on core-5; tighten confidence thresholds and reduce false-positive triggers instead.

Milestone: full system works untethered — auto-track, gesture-driven manual override (at least core 5), mode-switch, and lock-trigger all work reliably; all state feedback correct.

## Week 4 — Hardening + demo rehearsal (buffer week — use it fully)

- Full team: run the complete demo sequence start-to-finish at least 10 times; fix whatever breaks (BLE dropout, misclassified gestures under demo-room lighting/nerves, battery dying mid-demo, PIR false-triggers from the audience's own movement).
- Re-test gesture recognition specifically with whoever will perform it live on demo day — that person's accuracy matters more than the aggregate validation number.
- Time a full battery-life test on both turret and glove; recharge fully right before the actual demo.
- Write and rehearse a 60–90 second demo script: auto mode finds and tracks a person walking by → they put on the glove → recognized gestures pan/tilt the turret live → a flick locks on and fires the laser.

Layered fallback plan

If the on-device model misbehaves live → fall back to demonstrating auto-track mode alone (still a complete, impressive demo).

If the full 8-gesture set is shaky → demo only the core 5. This is not a failure — it is the Week 2 checkpoint working as intended.

Never let live gesture-AI accuracy be a single point of failure for the whole demo.

# 8. Risk Register

# | Risk | Mitigation

1 | Data collection is the real bottleneck, not model training | Start recording gestures in Week 1, not “when we get to it” — training itself takes minutes once data exists
2 | Model doesn't generalize beyond the people who trained it | Always validate with someone who provided zero training data before trusting any accuracy number
3 | BLE range/latency between glove and turret | Test in Week 2, not Week 3 — budget time to optimize or fall back to WiFi/ESP-NOW if laggy
4 | Servo torque under full sensor-rig weight | Weigh the fully-loaded top plate early; MG996R should be plenty, but trim mass if it strains/jitters
5 | PIR false-triggers on the audience's own movement | Aim it narrowly; test in the actual demo room if possible, not just a quiet lab
6 | Battery dies mid-demo | Test real runtime on both batteries in Week 4; always start the demo on a full charge
7 | Laser safety | Class 1/2 visible diode only — never anything marketed for burning/cutting; never aim at faces during testing or demo

# 9. One-Page Summary

If you remember nothing else from this manual

Budget: ₹4,780, under the ₹5,000 ceiling — no extra parts needed for the AI, only time.

Critical path: gesture data collection starts Week 1, not Week 2.

Checkpoint: end of Week 2, decide core-5-only vs. full 8-gesture stretch — deliberately, not by running out of time.

Fallback, always available: auto-track mode alone is a complete demo on its own.

Never let live AI accuracy be a single point of failure on demo day.

Gesture-Controlled Sentry Turret — Build Manual
